cassie-c-willis/UVA-MARS/README.md

# MARS-17-18
2017-2018 MARS Electrical and Software Repository

This was a joint collaboration effort project on which I worked on the electrical design and embedded code using the SPIN language.

See portfolio pages for a visual summary of completed work.
