cassie-c-willis/UVA-MARS/MARS portfolio page 1.docx

UVA Mechatronics and Robotics Society Mining Robot

NASA Robotic Mining Competition – Designed 2016-2018

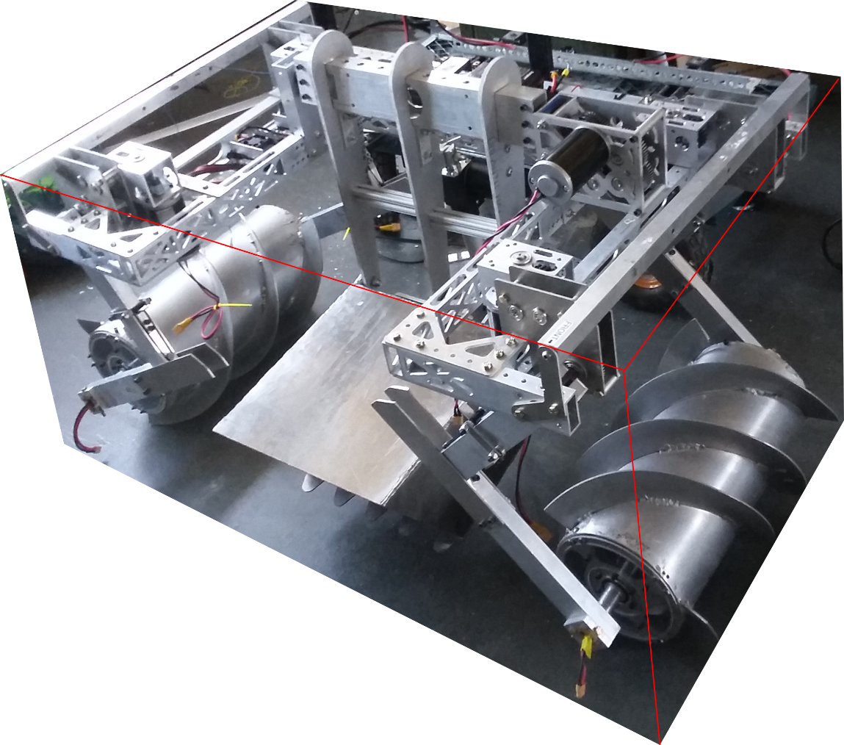
[picture p1: figure]
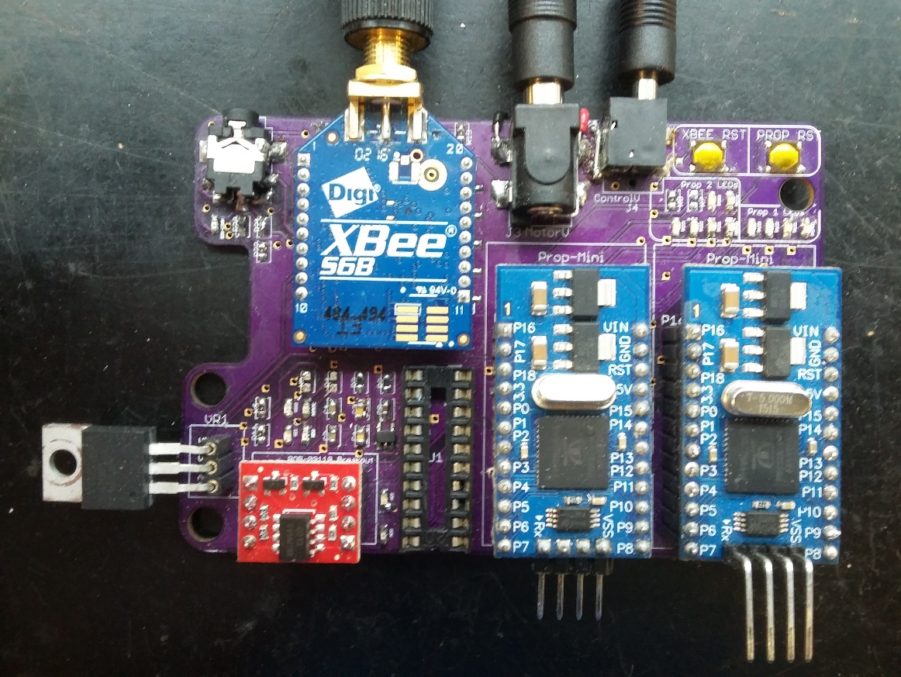
[picture p2: figure]
