cassie-c-willis/UVA-MARS/MARS portfolio page 2.docx

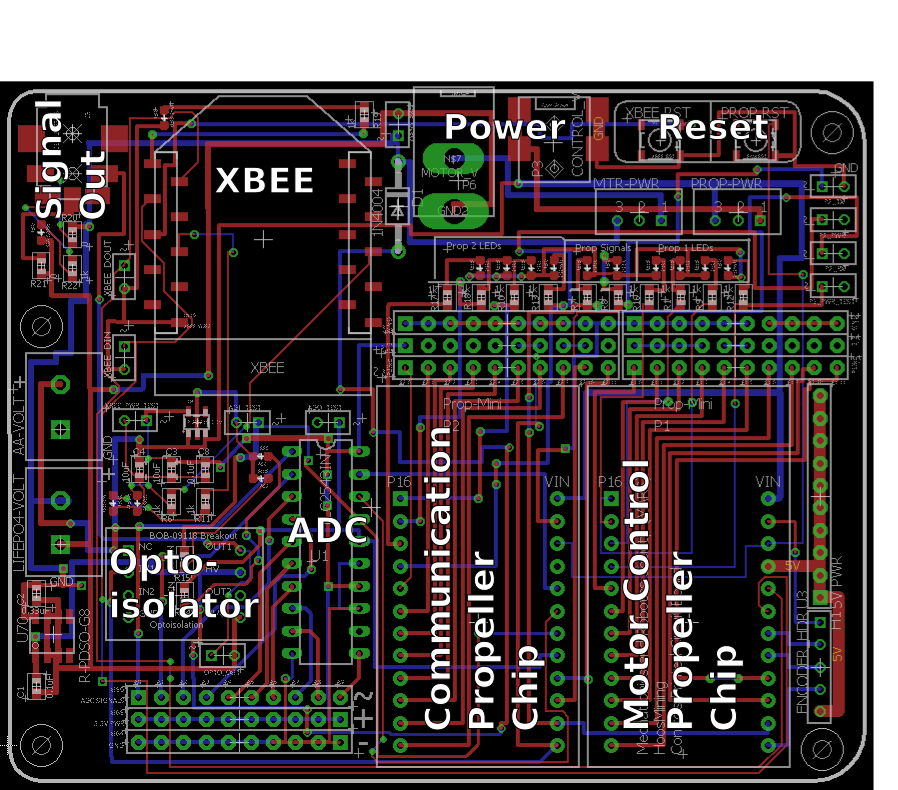
[picture p3: figure]
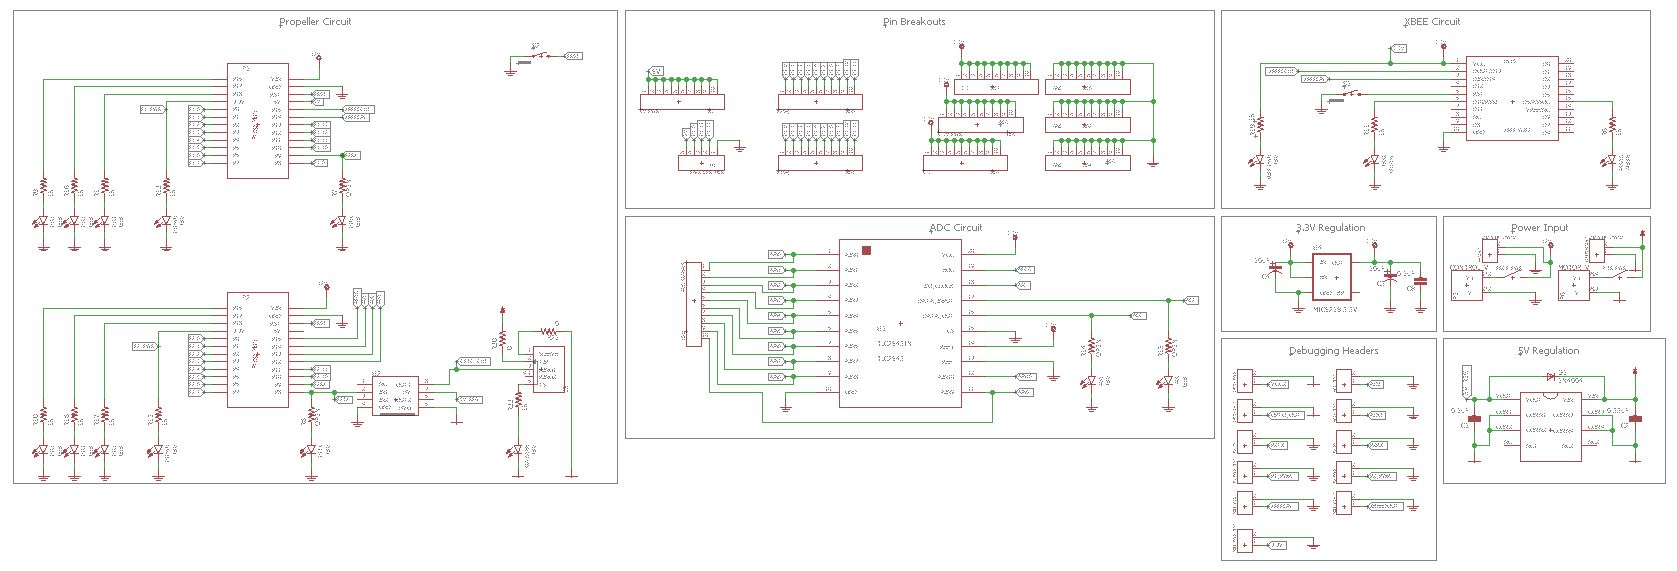
[picture p4: figure]
