cassie-c-willis/UVA-MARS/Circuitry/MARS-control/Inventory list for electronics.xlsx

Inventory List
Inventory ID | Name | Description | Unit Price | Quantity Needed | Quantity Available | Reorder Time in Days | Quantity in Reorder | Discontinued?
R0603 | Open Resistors | R20, R21 |  | 2
C0603 | 0.1uF Capacitor | C8 |  | 1
C-POL-T | 10uF Capacitor | C3, C4 |  | 2
C0603 | 10uF Capacitor | C1, C2 |  | 2
R0603 | 121 ohm Resistor | R2 |  | 1
R0603 | 1k ohm Resistor | R1, R4, R5, R6, R7, R8, R9, R10, R11, R12, R13, R14, R15, R16, R17, R18, R19, R22 |  | 18
R0603 | 365 ohm Resistor | R3 |  | 1
LED-STD | Blue LED | ADI, P1I1, P1I2, P1I3, P2I1, P2I2, P2I3, P2RX, XDI |  | 9 | 26
BOB-09118 | BOB09118 | U2 |  | 1
Single-LineA | ControlV | J4 |  | 1
LED-STD | Green LED | ASSOC |  | 1 | 8
LM1084 | LM1084 | VR1 |  | 1
V_REG_MIC52193.3V | 3,3V Regulator | U4 |  | 1 | 7
Single-Line-TR | MotorV | J3 |  | 1
Prop-Mini | Propeller Mini | P1, P2 |  | 2
SWITCH-MOMENTARY-2SMD-2 | PropRST | S2 |  | 1
LED-STD | Red LED | ADO, P1PWR, P2PWR, P2TX, SIG-CONN, XBEE-PWR, XDO |  | 7 | 18
SJI-42535TS | SJI-42535TS | J5 |  | 1
TLC2543IN | TLC2543IN | U1 |  | 1
SWITCH-MOMENTARY-2SMD-2 | XBEE-RST | S1 |  | 1
XBEE-WIFI | XBEE-WIFI | U$19 |  | 1
LED-STD | Yellow LED | RSSI |  | 1 | 9
CP-014DHP JCT-ND | Control Power | P3 |  | 1 | 4
CP-2184-ND | MotorV cables | MotorV cables |  | 1 | 9
