cassie-c-willis/UVA-MARS/Circuitry/MARS-control/ControlBoard_V0.1.brd

## EAGLE design Circuitry/MARS-control/ControlBoard_V0.1.brd (2017-09-10, an earlier design)

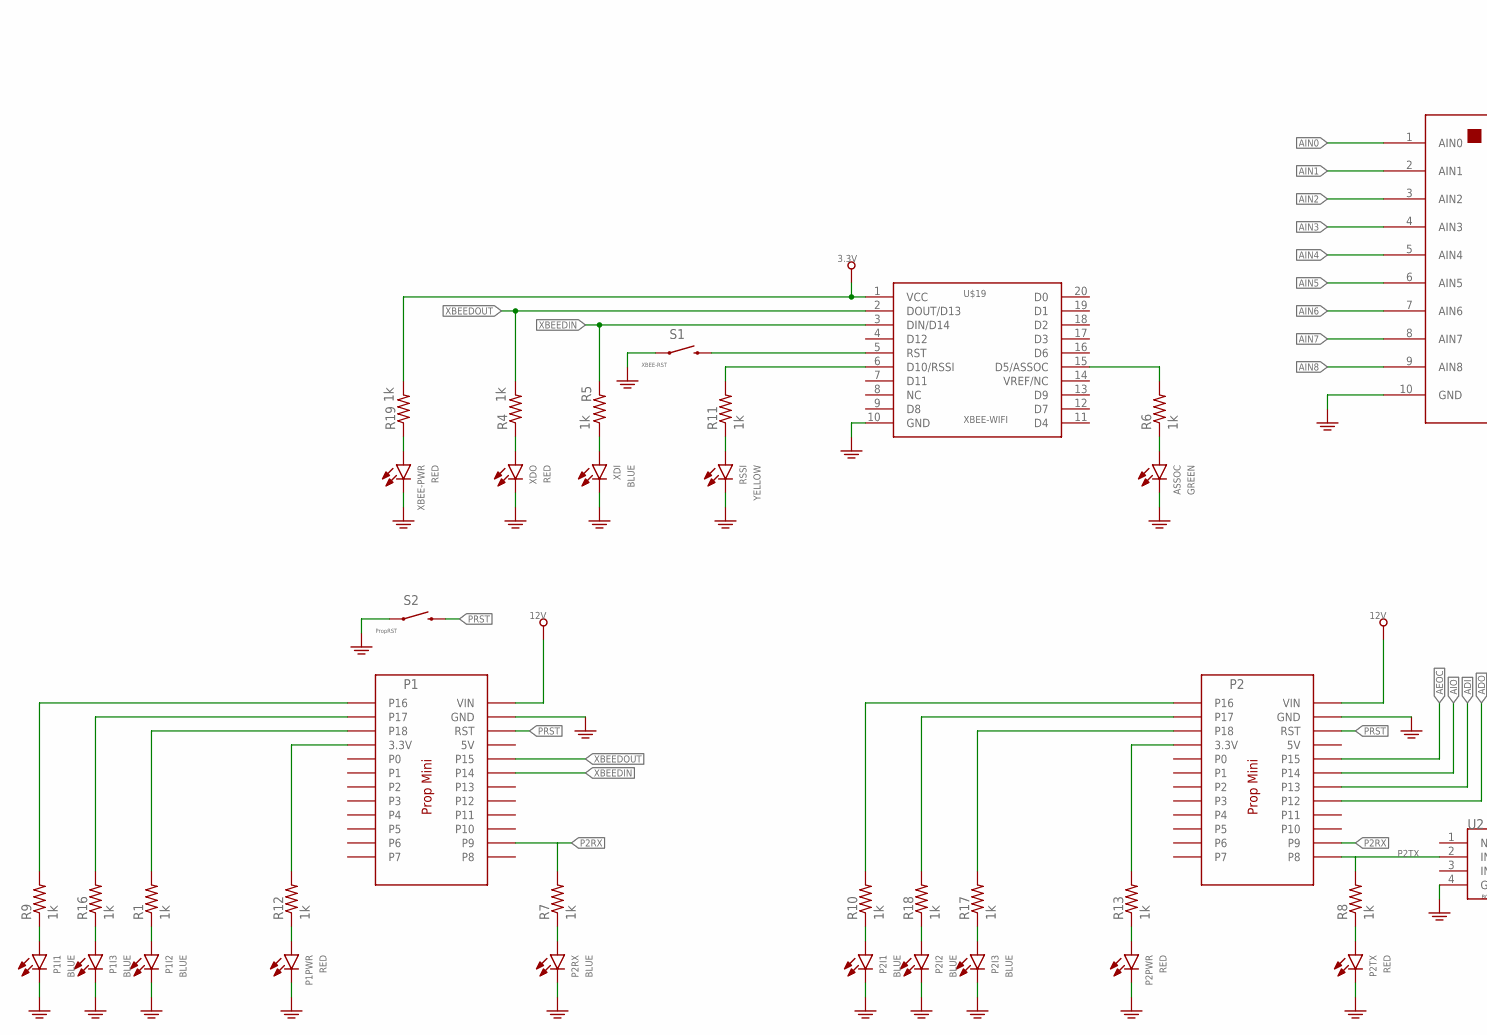
[picture p5: schematic ControlBoard_V0.1.sch, part in row 1, column 1]

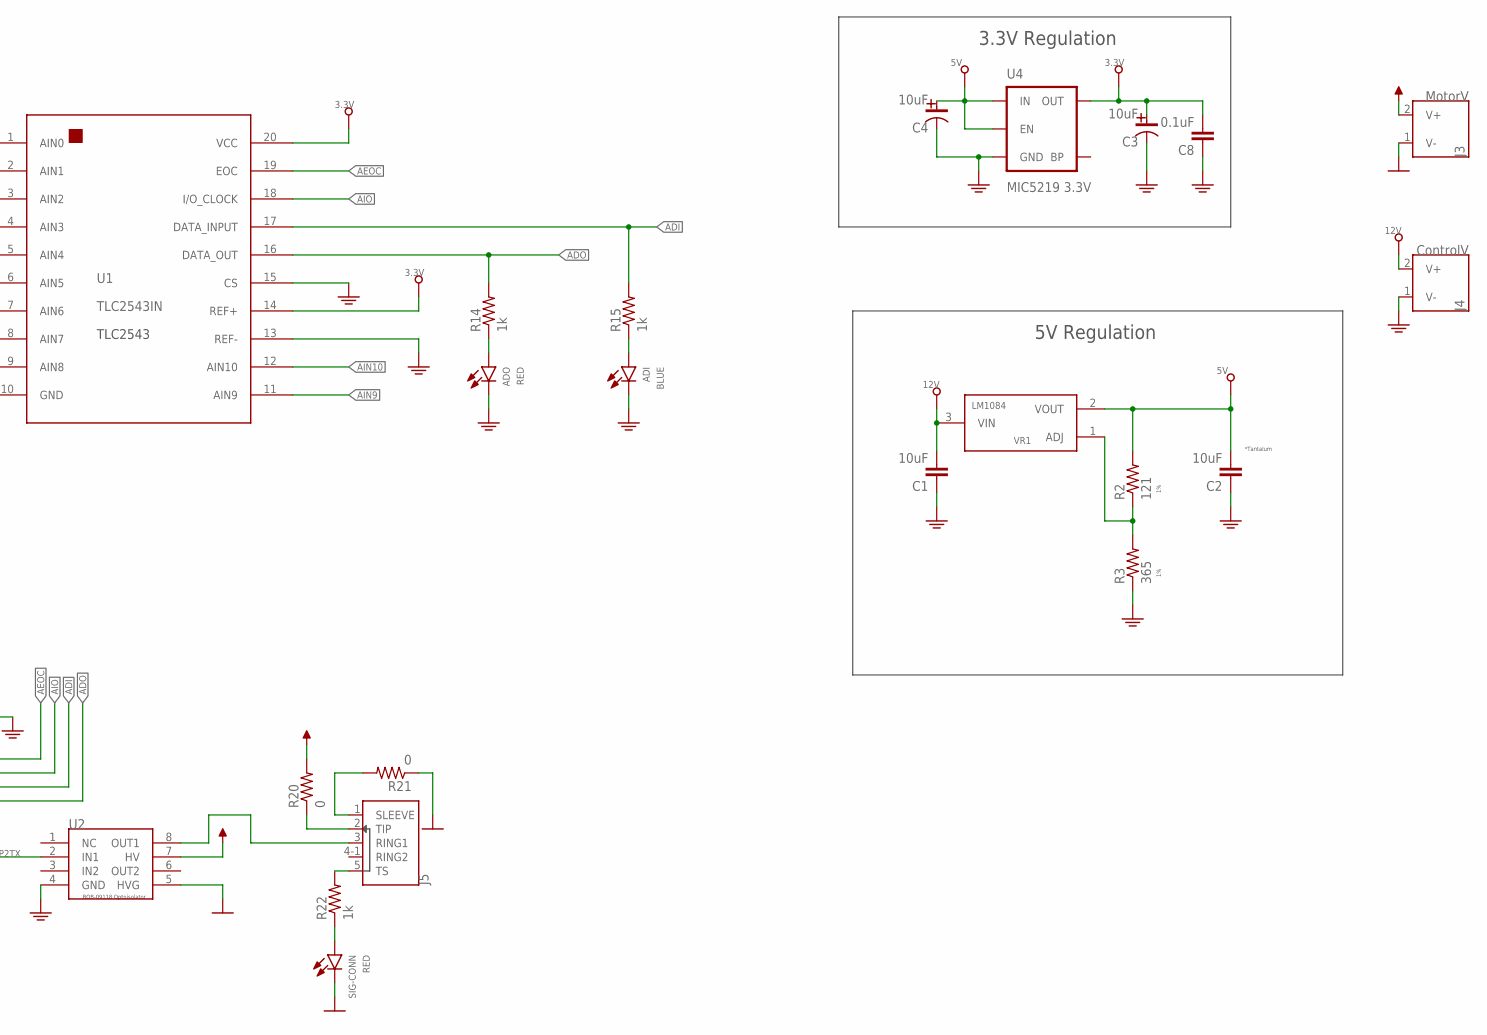
[picture p6: schematic ControlBoard_V0.1.sch, part in row 1, column 2]

Parts:
ADI: BLUE; 0603
ADO: RED; 0603
ASSOC: GREEN; 0603
C1, C2: 10uF; 0603
C3, C4: 10uF; 0603-POL
C8: 0.1uF; 0603
J3: MotorV; PJ-002BH-SMT
J4: ControlV; PJ-037A
J5: SJ1-42535TS; SJ1-42534-SMT
P1, P2: PROP-MINI
P1I1, P1I2, P1I3, P2I1, P2I2, P2I3, P2RX: BLUE; 0603
P1PWR, P2PWR, P2TX: RED; 0603
R1, R4, R5, R6, R7, R8, R9, R10, R11, R12, R13, R14, R15, R16, R17, R18, R19, R22: 1k; 0603
R2: 121; 0603
R3: 365; 0603
R20, R21: 0; 0603
RSSI: YELLOW; 0603
S1: XBEE-RST; TACTILE_SWITCH_SMD-2
S2: PropRST; TACTILE_SWITCH_SMD-2
SIG-CONN: RED; 0603
U1: TLC2543IN; DIL-20
U2: BOB-09118; DIL08-0.1P-6W
U4: MIC5219 3.3V; SOT23-5
U$19: XBEE-WIFI; XBEE-STD
VR1: LM1084; TO-220
XBEE-PWR: RED; 0603
XDI: BLUE; 0603
XDO: RED; 0603

Connections:
3.3V: C3.2, C8.2, R19.2, U1.14 (REF+), U1.20 (VCC), U4.5 (OUT), U$19.1 (VCC)
5V: C2.2, C4.2, R2.2, U4.1 (IN), U4.3 (EN), VR1.2 (VOUT)
12V: C1.2, J4.2 (V+), P1.VIN, P2.VIN, VR1.3 (VIN)
ADI: P2.P13, R15.2, U1.17 (DATA_INPUT)
ADO: P2.P12, R14.2, U1.16 (DATA_OUT)
AEOC: P2.P15, U1.19 (EOC)
AIN0: U1.1 (AIN0)
AIN1: U1.2 (AIN1)
AIN2: U1.3 (AIN2)
AIN3: U1.4 (AIN3)
AIN4: U1.5 (AIN4)
AIN5: U1.6 (AIN5)
AIN6: U1.7 (AIN6)
AIN7: U1.8 (AIN7)
AIN8: U1.9 (AIN8)
AIN9: U1.11 (AIN9)
AIN10: U1.12 (AIN10)
AIO: P2.P14, U1.18 (I/O_CLOCK)
GND: ADI.OUT, ADO.OUT, ASSOC.OUT, C1.1, C2.1, C3.1, C4.1, C8.1, J4.1 (V-), P1.GND, P1I1.OUT, P1I2.OUT, P1I3.OUT, P1PWR.OUT, P2.GND, P2I1.OUT, P2I2.OUT, P2I3.OUT, P2PWR.OUT, P2RX.OUT, P2TX.OUT, R3.1, RSSI.OUT, S1.2 (1), S2.2 (1), U1.10 (GND), U1.13 (REF-), U1.15 (CS), U2.4 (GND), U4.2 (GND), U$19.10 (GND), XBEE-PWR.OUT, XDI.OUT, XDO.OUT
GND2: J3.1 (V-), R21.1, SIG-CONN.OUT, U2.5 (HVG)
unnamed: R4.1, XDO.IN
unnamed: P1I1.IN, R9.1
unnamed: P1.P18, R1.2
unnamed: ADO.IN, R14.1
unnamed: R11.1, RSSI.IN
unnamed: ADI.IN, R15.1
unnamed: R5.1, XDI.IN
unnamed: J5.3 (RING1), U2.8 (OUT1)
unnamed: R6.2, U$19.15 (D5/ASSOC)
unnamed: ASSOC.IN, R6.1
unnamed: P1.3.3V, R12.2
unnamed: P1I3.IN, R16.1
unnamed: P2.3.3V, R13.2
unnamed: P1I2.IN, R1.1
unnamed: P1PWR.IN, R12.1
unnamed: R19.1, XBEE-PWR.IN
unnamed: J5.1 (SLEEVE), R21.2
unnamed: P2RX.IN, R7.1
unnamed: P2I1.IN, R10.1
unnamed: S1.1 (2), U$19.5 (RST)
unnamed: R2.1, R3.2, VR1.1 (ADJ)
unnamed: R11.2, U$19.6 (D10/RSSI)
unnamed: P1.P16, R9.2
unnamed: P2I2.IN, R18.1
unnamed: P2I3.IN, R17.1
unnamed: P1.P17, R16.2
unnamed: P2PWR.IN, R13.1
unnamed: P2TX.IN, R8.1
unnamed: J5.2 (TIP), R20.1
unnamed: R22.1, SIG-CONN.IN
unnamed: J5.5 (TS), R22.2
P2RX: P1.P9, P2.P9, R7.2
P2TX: P2.P8, R8.2, U2.2 (IN1)
PRST: P1.RST, P2.RST, S2.1 (2)
VCC2: J3.2 (V+), R20.2, U2.7 (HV)
XBEEDIN: P1.P14, R5.2, U$19.3 (DIN/D14)
XBEEDOUT: P1.P15, R4.2, U$19.2 (DOUT/D13)

Notes on the sheet:
*Tantalum
5V Regulation
3.3V Regulation

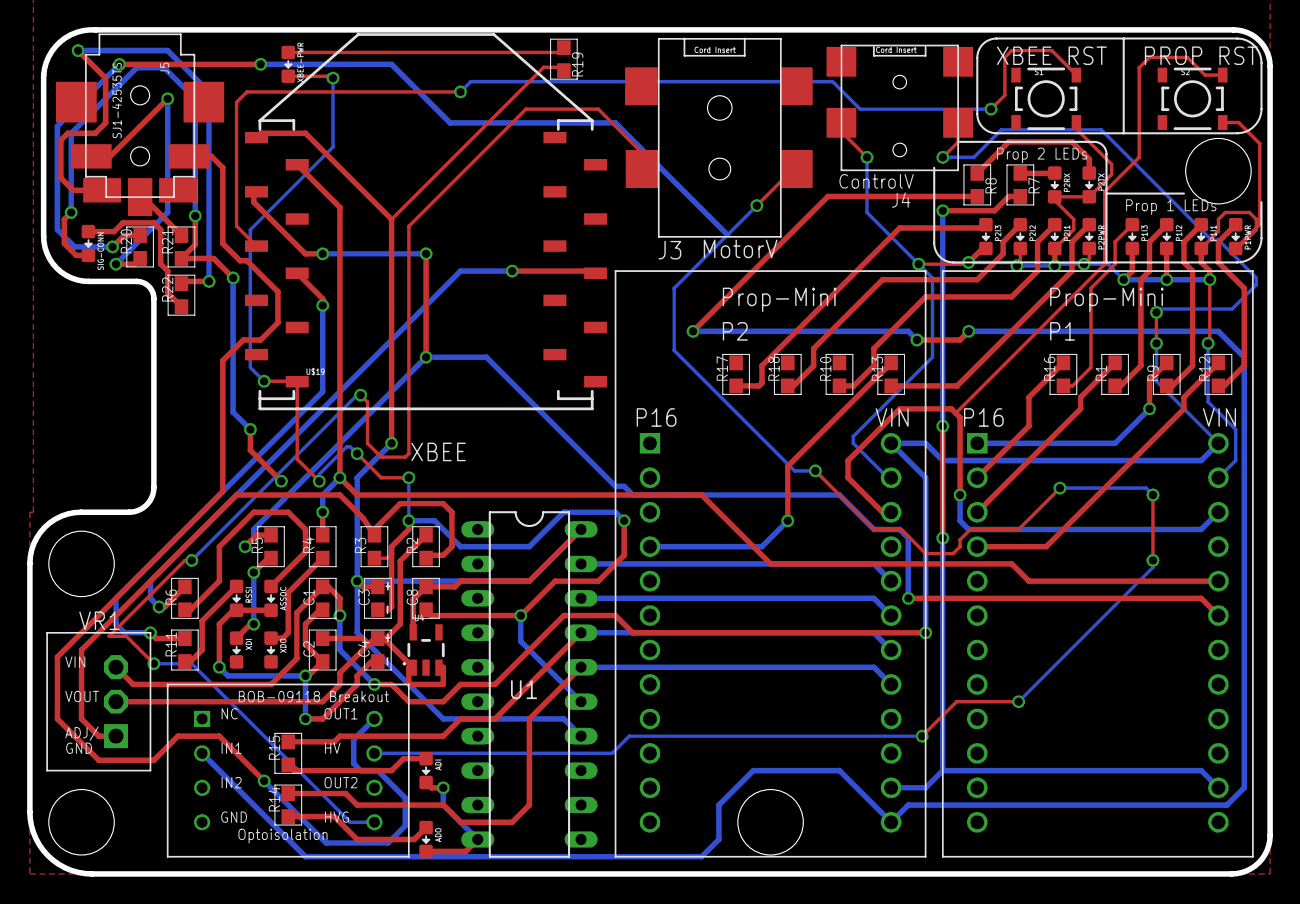
[picture p7: board ControlBoard_V0.1.brd from above]

Board: 2 copper layers, 91.4 x 62.2 mm, 57 parts (0 on the bottom side), 46 nets.
