cassie-c-willis/UVA-MARS/Circuitry/XBEE/XBee-Explorer.brd

## EAGLE design Circuitry/XBEE/XBee-Explorer.brd (2017-09-10)

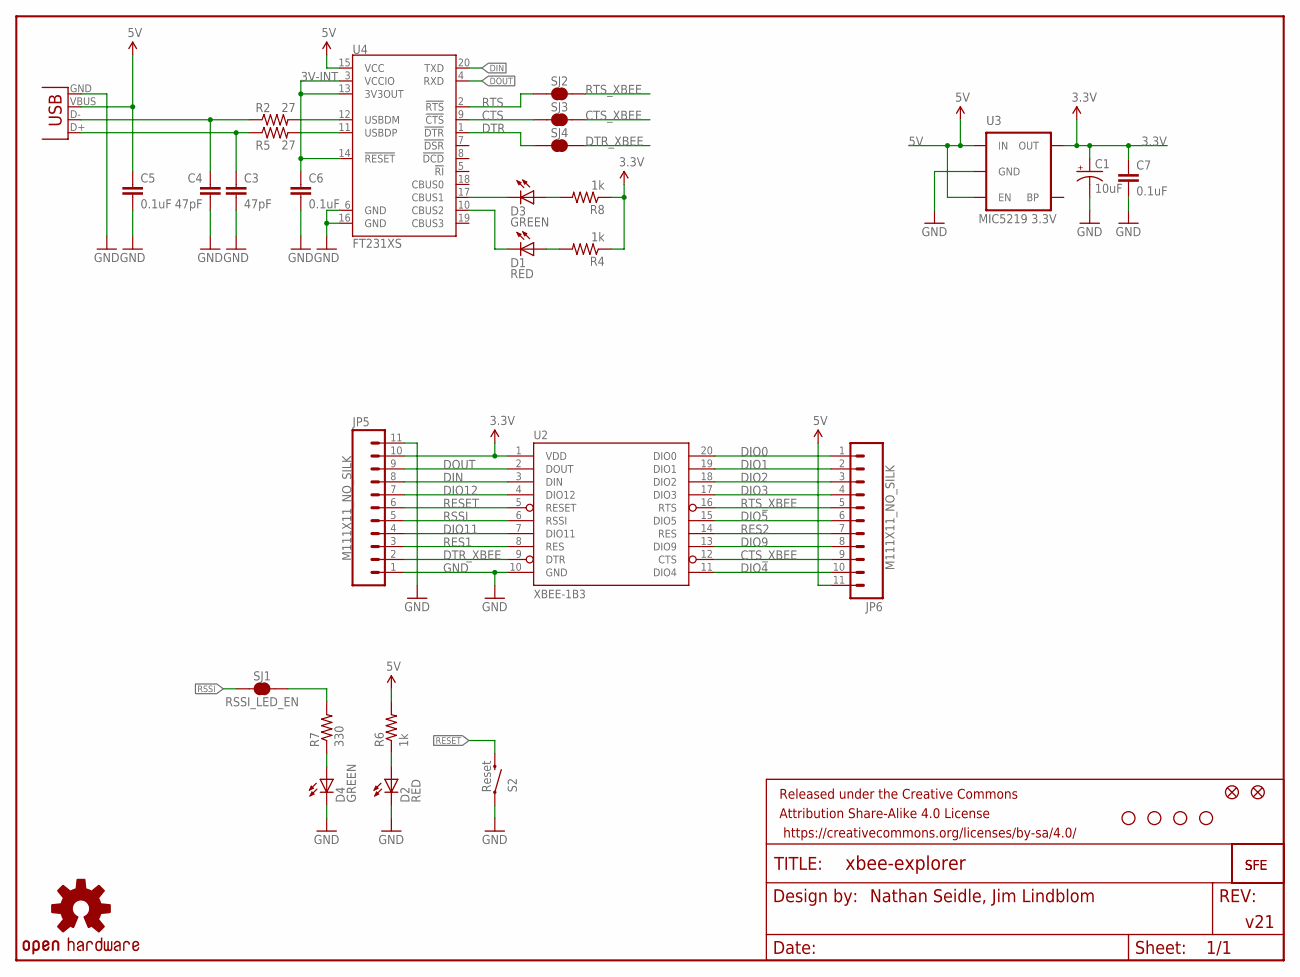
[picture p8: schematic XBee-Explorer.sch]

Parts:
C1: 10uF; EIA3216
C3, C4: 47pF; 0603-CAP
C5, C6, C7: 0.1uF; 0603-CAP
D1, D2: RED; LED-0603
D3, D4: GREEN; LED-0603
FRAME1: FRAME-LETTER; CREATIVE_COMMONS
JP1, JP4: FIDUCIAL1X2; FIDUCIAL-1X2
JP5, JP6: M111X11_NO_SILK; 1X11_NO_SILK
LOGO1: OSHW-LOGOS; OSHW-LOGO-S
R2, R5: 27; 0603-RES
R4, R6, R8: 1k; 0603-RES
R7: 330; 0603-RES
S2: Reset; TACTILE_SWITCH_SMD
SJ1: RSSI_LED_EN; SJ_2S-TRACE
SJ2: CTS_EN; SJ_2S-TRACE
SJ3: RTS_EN; SJ_2S-TRACE
SJ4: DTR; SJ_2S-TRACE
U2: XBEE-1B3; XBEE-SMD
U3: MIC5219 3.3V; SOT23-5
U4: FT231XS; SSOP20_L
U$1: LOGO-SFESK; SFE-LOGO-FLAME
U$4: LOGO-SFENEW; SFE-NEW-WEBLOGO
U$5, U$9, U$10, U$11: STAND-OFF
X1: USBSMD; USB-MINIB

Connections:
3.3V: C1.A (+), C7.1, JP5.10, R4.1, R8.1, U2.1 (VDD), U3.5 (OUT)
3V-INT: C6.1, U4.3 (VCCIO), U4.13 (3V3OUT), U4.14 (!RESET)
5V: C5.1, JP6.11, R6.2, U3.1 (IN), U3.3 (EN), U4.15 (VCC), X1.VBUS
CTS: SJ3.1, U4.9 (!CTS)
CTS_XBEE: JP6.9, SJ3.2, U2.12 (CTS)
DIN: JP5.8, U2.3 (DIN), U4.20 (TXD)
DIO0: JP6.1, U2.20 (DIO0)
DIO1: JP6.2, U2.19 (DIO1)
DIO2: JP6.3, U2.18 (DIO2)
DIO3: JP6.4, U2.17 (DIO3)
DIO4: JP6.10, U2.11 (DIO4)
DIO5: JP6.6, U2.15 (DIO5)
DIO9: JP6.8, U2.13 (DIO9)
DIO11: JP5.4, U2.7 (DIO11)
DIO12: JP5.7, U2.4 (DIO12)
DOUT: JP5.9, U2.2 (DOUT), U4.4 (RXD)
DTR: SJ4.1, U4.1 (!DTR)
DTR_XBEE: JP5.2, SJ4.2, U2.9 (DTR)
GND: C1.C (-), C3.2, C4.2, C5.2, C6.2, C7.2, D2.C, D4.C, JP5.1, JP5.11, S2.1, U2.10 (GND), U3.2 (GND), U4.6 (GND), U4.16 (GND), X1.GND
unnamed: D1.A, R4.2
unnamed: D4.A, R7.1
unnamed: C3.1, R5.1, X1.D+
unnamed: D3.A, R8.2
unnamed: C4.1, R2.1, X1.D-
unnamed: D3.C, U4.17 (CBUS1)
unnamed: R5.2, U4.11 (USBDP)
unnamed: R2.2, U4.12 (USBDM)
unnamed: R7.2, SJ1.2
unnamed: D2.A, R6.1
RES1: JP5.3, U2.8 (RES)
RES2: JP6.7, U2.14 (RES)
RESET: JP5.6, S2.3 (2), U2.5 (RESET)
RSSI: JP5.5, SJ1.1, U2.6 (RSSI)
RTS: SJ2.1, U4.2 (!RTS)
RTS_XBEE: JP6.5, SJ2.2, U2.16 (RTS)
TXLED: D1.C, U4.10 (CBUS2)

Notes on the sheet:
Nathan Seidle, Jim Lindblom
v21

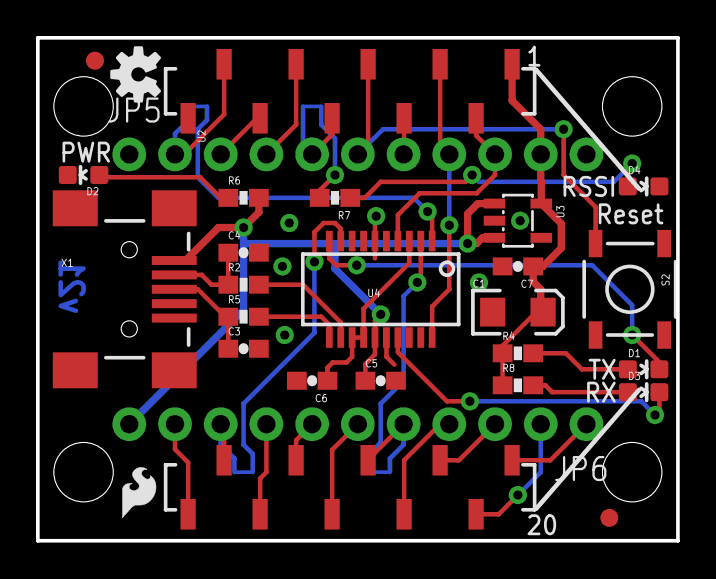
[picture p9: board XBee-Explorer.brd from above]

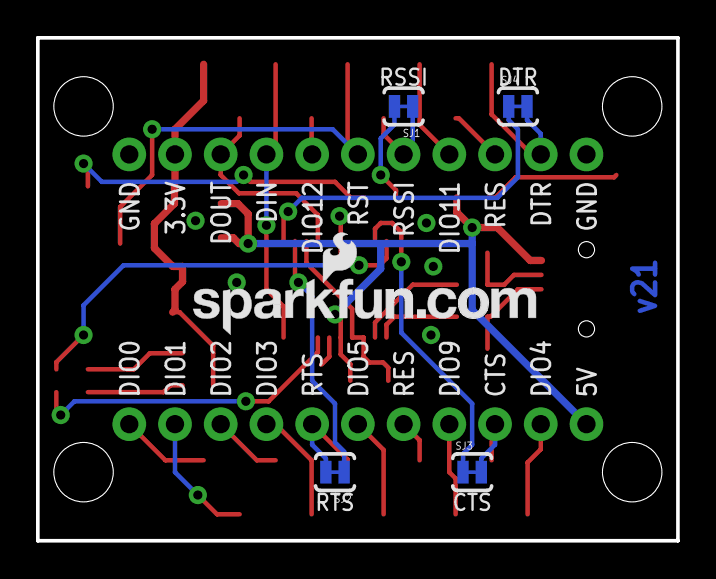
[picture p10: board XBee-Explorer.brd from below]

Board: 2 copper layers, 35.6 x 27.9 mm, 37 parts (5 on the bottom side), 36 nets.
