cassie-c-willis/UVA-MARS/(commit log)

2017-09-10 adding all files from last year
    [ControlBoard_BOM_V0.1.csv, ControlBoard_V0.1.brd, ControlBoard_V0.1.sch, Inventory list for electronics.xlsx, NASA-RMC-RouterConfig-backup.cfg, XBee-Explorer.brd, XBee-Explorer.sch, control board 1.brd]
2018-02-09 main propeller code on motorTesting.spin
2018-04-13 Added basic motor functions, untested
2018-04-15 Robot moves now, added right screw and bucket
2018-05-09 finished bucket active control
2018-09-05 Create motorTestC
